openenergymonitor/emontx2/accuracy.md

# emonTx V2 Accuracy Test

### Summary

_The test detailed below performed on one emontx comes to the following conclusion:_

_The error below 40W could not be measured reliably and below 100W it was worse than 10%. Above 100W it was better than 10%, above 150W better than 6%, above 250W better than 4% and above 500W better than 2%._

It may be that your emontx will surpass or fail to achieve these accuracy levels depending on:

1) Calibration - as demonstrated in this test, it may be necessary to apply an additional calibration, the precision of the different components in the circuit means that the voltage calibration can be anywhere between  203.1 – 265.4 while the current sensor calibration can be anywhere between 109.44 – 112.78see [CT and AC power adapter installation and calibration theory](https://learn.openenergymonitor.org/electricity-monitoring/ctac/calibration)

2) Bias position will have a large effect on accuracy at low powers see: [https://learn.openenergymonitor.org/electricity-monitoring/ct-sensors/measurement-implications-of-adc-resolution-at-low-current-values](https://learn.openenergymonitor.org/electricity-monitoring/ct-sensors/measurement-implications-of-adc-resolution-at-low-current-values)

3) Level of electro-magnetic interference in your environment. Some laptops and switch mode power supplies can be a large source ofÂ electro-magnetic interference. Whether your circuit is shielded in any way i.e inside a metal box. A certain level of noise is actually a good thing as it helps overcome the limitations of trying to measure power where the current waveform is close to the ADC level magnitude, by causing the levels to flip higher and lower which after averaging gives a more accurate result.

If you could also repeat this test and post up your results, it would be great to get some comparative data of different emontx's in real world use.

If your also a non-emontx user but have build the emontx circuit on a breadboard, stripboard or arduino shield protoboard it would also be interesting to compare results.

### Test setup

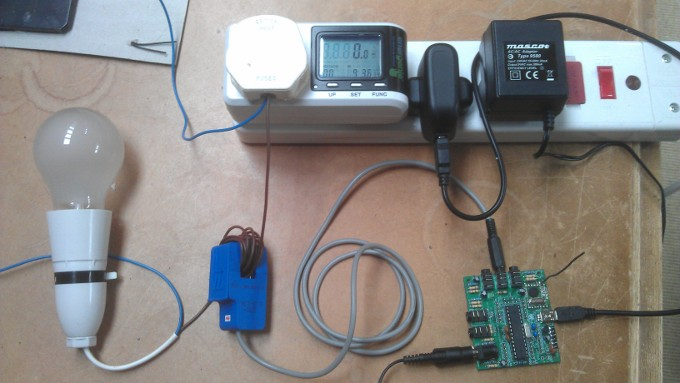
[picture p9: docs/testsetup01.jpg]


The test setup consists of an emontx with the standard Mascot AC-AC voltage adapter for voltage measurement and the standard current sensor, a YHDC sct-013-000 CT. The emonTx is powered via a 5 V USB power supply. The EmonTx sends the realpower values wirelessly to a jeelink that is connected to the computer.

The normal emonTx_CT123_Voltage sketch was used, the measurement rate was increased from once every 5 seconds to twice a second.

The CT is clipped around a modified cable that goes to a fixed load (a 20W and 60W incandescent lightbulb was used in the test). The cable modification was to separate the live and neutral wires and getting enough cable length to wrap around the CT up to 14 times in the case of this test.

A 20W and 60W incandescent lightbulb was used to ensure that the current waveform would be a near-sinusoidal waveform. It is expected that a low energy lightbulb may show higher accuracy at lower powers as its non-linear current draw, a current draw that looks more like a spike at the peak of the mains voltage waveform will utilise more ADC levels, seeÂ [Measurement implications of ADC resolution at low current values](https://learn.openenergymonitor.org/electricity-monitoring/ct-sensors/measurement-implications-of-adc-resolution-at-low-current-values).

### Test procedure

The test was performed in two parts: first 1-14 turns with a 20W lightbulb and second 1-14 turns with a 60W lightbulb. Care was taken each time to make sure that the CT was clipped firmly, that the contact between the split cores where good and that there was no observable effect in trying to push the cores closer together - indicating good contact.

The measurements were logged to a text file and opened and graphed in realtime using KST, an open source data viewing program. KST was set to a data range of 20 datapoints and a label was created to show the Min, Max, Mean and Standard deviation (Sigma) of the power data.

20 datapoints at 2 datapoints a second covers a time window of 10 seconds for eachÂ Min, Max, Mean and Standard deviation measurement. Care was taken to make sure that the mains voltage did not vary significantly during the sample duration.

**Min:** the minimum power value in the sample of 20 datapoints.

**Max:** the maximum power value in the sample of 20 datapoints.

**Mean:** the mean value of the 20 datapoints.

**Standard deviation:** the [standard deviation](https://en.wikipedia.org/wiki/Standard_deviation)Â of the 20 datapoints

These values where logged alongside the actual power as given by the plug meter multiplied by the number of turns in a spreadsheet.

### Uncalibrated ResultsÂ

These are the raw results, its clear that there is a significant calibration error as the error appears to increase in a particular direction linearly:

**The plug in meter column** on the left shows the number of watts as measured on the plug in meter: 21W relates to the actual power consumption of the 20W incandescent lightbulb, 60W relates to the actual power consumption of the 60W lightbulb.

**The number of turn column** is the number of turns of the live or neutral wire in the CT. The number of turns multiplied by the plug in meter power gives the power (or actually current) level as seen by the CT.

<table border="0" cellspacing="0" cols="12" frame="VOID" rules="NONE"><colgroup><col width="103"></colgroup> <colgroup><col width="80"></colgroup> <colgroup><col width="72"></colgroup> <colgroup><col width="77"></colgroup> <colgroup><col width="86"></colgroup> <colgroup><col width="86"></colgroup> <colgroup><col width="86"></colgroup> <colgroup><col width="86"></colgroup> <colgroup><col width="86"></colgroup> <colgroup><col width="86"></colgroup> <colgroup><col width="86"></colgroup> <colgroup><col width="95"></colgroup>

<tbody>

<tr>

<td align="CENTER" height="17" width="103">**plug in meter**</td>

<td align="CENTER" width="80">**no of turns**</td>

<td align="CENTER" width="72">**CT power**</td>

<td align="CENTER" bgcolor="#E6E6FF" width="77">**Max (A)**</td>

<td align="CENTER" bgcolor="#E6E6FF" width="86">**Min (B)**</td>

<td align="CENTER" bgcolor="#E6E6FF" width="86">**Mean**</td>

<td align="CENTER" bgcolor="#E6E6FF" width="86">**Standard Deviation**</td>

<td align="CENTER" width="86">**error (A)**</td>

<td align="CENTER" width="86">**error (B)**</td>

<td align="CENTER" width="86">**% error (A)**</td>

<td align="CENTER" width="86">**% error (B)**</td>

<td align="CENTER" bgcolor="#E6E6FF" width="95">**MAX % error**</td>

</tr>

<tr>

<td align="CENTER" height="17" sdnum="2057;" sdval="21">21</td>

<td align="CENTER" sdnum="2057;" sdval="1">1</td>

<td align="CENTER" sdnum="2057;" sdval="21">21</td>

<td align="CENTER" bgcolor="#E6E6FF" sdnum="2057;" sdval="30">30</td>

<td align="CENTER" bgcolor="#E6E6FF" sdnum="2057;" sdval="10">10</td>

<td align="CENTER" bgcolor="#E6E6FF" sdnum="2057;" sdval="21.8">21.8</td>

<td align="CENTER" bgcolor="#E6E6FF" sdnum="2057;" sdval="5.4">5.4</td>

<td align="CENTER" sdnum="2057;" sdval="9">9</td>

<td align="CENTER" sdnum="2057;" sdval="11">11</td>

<td align="CENTER" sdnum="2057;0;0.00%" sdval="0.428571428571429">42.86%</td>

<td align="CENTER" sdnum="2057;0;0.00%" sdval="0.523809523809524">52.38%</td>

<td align="CENTER" bgcolor="#E6E6FF" sdnum="2057;0;0.00%" sdval="0.523809523809524">52.38%</td>

</tr>

<tr>

<td align="CENTER" height="17" sdnum="2057;" sdval="21">21</td>

<td align="CENTER" sdnum="2057;" sdval="2">2</td>

<td align="CENTER" sdnum="2057;" sdval="42">42</td>

<td align="CENTER" bgcolor="#E6E6FF" sdnum="2057;" sdval="45">45</td>

<td align="CENTER" bgcolor="#E6E6FF" sdnum="2057;" sdval="36">36</td>

<td align="CENTER" bgcolor="#E6E6FF" sdnum="2057;" sdval="39">39</td>

<td align="CENTER" bgcolor="#E6E6FF" sdnum="2057;" sdval="3">3</td>

<td align="CENTER" sdnum="2057;" sdval="3">3</td>

<td align="CENTER" sdnum="2057;" sdval="6">6</td>

<td align="CENTER" sdnum="2057;0;0.00%" sdval="0.0714285714285714">7.14%</td>

<td align="CENTER" sdnum="2057;0;0.00%" sdval="0.142857142857143">14.29%</td>

<td align="CENTER" bgcolor="#E6E6FF" sdnum="2057;0;0.00%" sdval="0.142857142857143">14.29%</td>

</tr>

<tr>

<td align="CENTER" height="17" sdnum="2057;" sdval="21">21</td>

<td align="CENTER" sdnum="2057;" sdval="3">3</td>

<td align="CENTER" sdnum="2057;" sdval="63">63</td>

<td align="CENTER" bgcolor="#E6E6FF" sdnum="2057;" sdval="63">63</td>

<td align="CENTER" bgcolor="#E6E6FF" sdnum="2057;" sdval="52">52</td>

<td align="CENTER" bgcolor="#E6E6FF" sdnum="2057;" sdval="60">60</td>

<td align="CENTER" bgcolor="#E6E6FF" sdnum="2057;" sdval="3.3">3.3</td>

<td align="CENTER" sdnum="2057;" sdval="0">0</td>

<td align="CENTER" sdnum="2057;" sdval="11">11</td>

<td align="CENTER" sdnum="2057;0;0.00%" sdval="0">0.00%</td>

<td align="CENTER" sdnum="2057;0;0.00%" sdval="0.174603174603175">17.46%</td>

<td align="CENTER" bgcolor="#E6E6FF" sdnum="2057;0;0.00%" sdval="0.174603174603175">17.46%</td>

</tr>

<tr>

<td align="CENTER" height="17" sdnum="2057;" sdval="21">21</td>

<td align="CENTER" sdnum="2057;" sdval="4">4</td>

<td align="CENTER" sdnum="2057;" sdval="84">84</td>

<td align="CENTER" bgcolor="#E6E6FF" sdnum="2057;" sdval="83">83</td>

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

</tr>

<tr>

<td align="CENTER" height="17" sdnum="2057;" sdval="61">61</td>

<td align="CENTER" sdnum="2057;" sdval="13">13</td>

<td align="CENTER" sdnum="2057;" sdval="793">793</td>

<td align="CENTER" bgcolor="#E6E6FF" sdnum="2057;" sdval="752">752</td>

<td align="CENTER" bgcolor="#E6E6FF" sdnum="2057;" sdval="743">743</td>

<td align="CENTER" bgcolor="#E6E6FF" sdnum="2057;" sdval="746">746</td>

<td align="CENTER" bgcolor="#E6E6FF" sdnum="2057;" sdval="2.2">2.2</td>

<td align="CENTER" sdnum="2057;" sdval="-41">-41</td>

<td align="CENTER" sdnum="2057;" sdval="50">50</td>

<td align="CENTER" sdnum="2057;0;0.00%" sdval="-0.0517023959646911">-5.17%</td>

<td align="CENTER" sdnum="2057;0;0.00%" sdval="0.0630517023959647">6.31%</td>

<td align="CENTER" bgcolor="#E6E6FF" sdnum="2057;0;0.00%" sdval="0.0630517023959647">6.31%</td>

</tr>

<tr>

<td align="CENTER" height="17" sdnum="2057;" sdval="61">61</td>

<td align="CENTER" sdnum="2057;" sdval="14">14</td>

<td align="CENTER" sdnum="2057;" sdval="854">854</td>

<td align="CENTER" bgcolor="#E6E6FF" sdnum="2057;" sdval="805">805</td>

<td align="CENTER" bgcolor="#E6E6FF" sdnum="2057;" sdval="798">798</td>

<td align="CENTER" bgcolor="#E6E6FF" sdnum="2057;" sdval="801">801</td>

<td align="CENTER" bgcolor="#E6E6FF" sdnum="2057;" sdval="2.2">2.2</td>

<td align="CENTER" sdnum="2057;" sdval="-49">-49</td>

<td align="CENTER" sdnum="2057;" sdval="56">56</td>

<td align="CENTER" sdnum="2057;0;0.00%" sdval="-0.0573770491803279">-5.74%</td>

<td align="CENTER" sdnum="2057;0;0.00%" sdval="0.0655737704918033">6.56%</td>

<td align="CENTER" bgcolor="#E6E6FF" sdnum="2057;0;0.00%" sdval="0.0655737704918033">6.56%</td>

</tr>

</tbody>

</table>

### Applying a calibration

The calibration factor was calculated by dividing the plug in power 854W by the mean emontx power of 801W.

**Calibration factor: 1.066**

The next question is whether this error is down to voltage measurement only or is also down to current measurement or some other source. Comparing the voltage measured on the plug meter: 251.2V and the emontx 242.5 it looks like the difference here accounts for just over half the error.Â

Applying the calibration:

<table border="0" cellspacing="0" cols="14" frame="VOID" rules="NONE"><colgroup><col width="86"></colgroup> <colgroup><col width="86"></colgroup> <colgroup><col width="86"></colgroup> <colgroup><col width="86"></colgroup> <colgroup><col width="86"></colgroup> <colgroup><col width="86"></colgroup> <colgroup><col width="86"></colgroup> <colgroup><col width="86"></colgroup> <colgroup><col width="86"></colgroup> <colgroup><col width="86"></colgroup> <colgroup><col width="86"></colgroup> <colgroup><col width="86"></colgroup> <colgroup><col width="86"></colgroup> <colgroup><col width="121"></colgroup>

<tbody>

<tr>

<td align="CENTER" height="17" width="86">**plug in meter**</td>

<td align="CENTER" width="86">**no of turns**</td>

<td align="CENTER" width="86">**CT power**</td>

<td align="CENTER" width="86">**Max**</td>

<td align="CENTER" width="86">**Min**</td>

<td align="CENTER" bgcolor="#E6E6FF" width="86">**Max CAL (A)**</td>

<td align="CENTER" bgcolor="#E6E6FF" width="86">**Min CAL (B)**</td>

<td align="CENTER" width="86">**Mean**</td>

<td align="CENTER" width="86">

**Standard Deviation**

</td>

<td align="CENTER" sdnum="2057;0;0.0" width="86">**error (A)**</td>

<td align="CENTER" sdnum="2057;0;0.0" width="86">

**error (B)**

</td>

<td align="CENTER" sdnum="2057;0;0.0" width="86">**% error (A)**</td>

<td align="CENTER" sdnum="2057;0;0.0" width="86">**% error (B)**</td>

<td align="CENTER" bgcolor="#E6E6FF" width="121">**MAX % error**</td>

</tr>

<tr>

<td align="CENTER" height="17" sdnum="2057;" sdval="21">21</td>

<td align="CENTER" sdnum="2057;" sdval="1">1</td>

<td align="CENTER" sdnum="2057;" sdval="21">21</td>

<td align="CENTER" sdnum="2057;" sdval="30">30</td>

<td align="CENTER" sdnum="2057;" sdval="10">10</td>

<td align="CENTER" bgcolor="#E6E6FF" sdnum="2057;0;0" sdval="31.9850187265918">32</td>

<td align="CENTER" bgcolor="#E6E6FF" sdnum="2057;0;0" sdval="10.6616729088639">11</td>

<td align="CENTER" sdnum="2057;" sdval="21.8">21.8</td>

<td align="CENTER" sdnum="2057;" sdval="5.4">5.4</td>

<td align="CENTER" sdnum="2057;0;0.0" sdval="10.9850187265918">11.0</td>

<td align="CENTER" sdnum="2057;0;0.0" sdval="10.3383270911361">10.3</td>

<td align="CENTER" sdnum="2057;0;0.00%" sdval="0.523096129837703">52.31%</td>

<td align="CENTER" sdnum="2057;0;0.00%" sdval="0.492301290054099">49.23%</td>

<td align="CENTER" bgcolor="#E6E6FF" sdnum="2057;0;0.00%" sdval="0.523096129837703">52.31%</td>

</tr>

<tr>

<td align="CENTER" height="17" sdnum="2057;" sdval="21">21</td>

<td align="CENTER" sdnum="2057;" sdval="2">2</td>

<td align="CENTER" sdnum="2057;" sdval="42">42</td>

<td align="CENTER" sdnum="2057;" sdval="45">45</td>

<td align="CENTER" sdnum="2057;" sdval="36">36</td>

<td align="CENTER" bgcolor="#E6E6FF" sdnum="2057;0;0" sdval="47.9775280898876">48</td>

<td align="CENTER" bgcolor="#E6E6FF" sdnum="2057;0;0" sdval="38.3820224719101">38</td>

<td align="CENTER" sdnum="2057;" sdval="39">39</td>

<td align="CENTER" sdnum="2057;" sdval="3">3</td>

<td align="CENTER" sdnum="2057;0;0.0" sdval="5.97752808988763">6.0</td>

<td align="CENTER" sdnum="2057;0;0.0" sdval="3.61797752808989">3.6</td>

<td align="CENTER" sdnum="2057;0;0.00%" sdval="0.142322097378277">14.23%</td>

<td align="CENTER" sdnum="2057;0;0.00%" sdval="0.0861423220973783">8.61%</td>

<td align="CENTER" bgcolor="#E6E6FF" sdnum="2057;0;0.00%" sdval="0.142322097378277">14.23%</td>

</tr>

<tr>

<td align="CENTER" height="17" sdnum="2057;" sdval="61">61</td>

<td align="CENTER" sdnum="2057;" sdval="1">1</td>

<td align="CENTER" sdnum="2057;" sdval="61">61</td>

<td align="CENTER" sdnum="2057;" sdval="64">64</td>

<td align="CENTER" sdnum="2057;" sdval="57">57</td>

<td align="CENTER" bgcolor="#E6E6FF" sdnum="2057;0;0" sdval="68.2347066167291">68</td>

<td align="CENTER" bgcolor="#E6E6FF" sdnum="2057;0;0" sdval="60.7715355805243">61</td>

<td align="CENTER" sdnum="2057;" sdval="62.2">62.2</td>

<td align="CENTER" sdnum="2057;" sdval="2">2</td>

<td align="CENTER" sdnum="2057;0;0.0" sdval="7.23470661672909">7.2</td>

<td align="CENTER" sdnum="2057;0;0.0" sdval="0.228464419475657">0.2</td>

<td align="CENTER" sdnum="2057;0;0.00%" sdval="0.118601747815231">11.86%</td>

<td align="CENTER" sdnum="2057;0;0.00%" sdval="0.00374531835205994">0.37%</td>

<td align="CENTER" bgcolor="#E6E6FF" sdnum="2057;0;0.00%" sdval="0.118601747815231">11.86%</td>

</tr>

<tr>

<td align="CENTER" height="17" sdnum="2057;" sdval="21">21</td>

<td align="CENTER" sdnum="2057;" sdval="3">3</td>

<td align="CENTER" sdnum="2057;" sdval="63">63</td>

<td align="CENTER" sdnum="2057;" sdval="63">63</td>

<td align="CENTER" sdnum="2057;" sdval="52">52</td>

<td align="CENTER" bgcolor="#E6E6FF" sdnum="2057;0;0" sdval="67.1685393258427">67</td>

<td align="CENTER" bgcolor="#E6E6FF" sdnum="2057;0;0" sdval="55.4406991260924">55</td>

<td align="CENTER" sdnum="2057;" sdval="60">60</td>

<td align="CENTER" sdnum="2057;" sdval="3.3">3.3</td>

<td align="CENTER" sdnum="2057;0;0.0" sdval="4.16853932584269">4.2</td>

<td align="CENTER" sdnum="2057;0;0.0" sdval="7.55930087390762">7.6</td>

<td align="CENTER" sdnum="2057;0;0.00%" sdval="0.0661672908863919">6.62%</td>

<td align="CENTER" sdnum="2057;0;0.00%" sdval="0.119988902760438">12.00%</td>

<td align="CENTER" bgcolor="#E6E6FF" sdnum="2057;0;0.00%" sdval="0.119988902760438">12.00%</td>

</tr>

<tr>

<td align="CENTER" height="17" sdnum="2057;" sdval="21">21</td>

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

<td align="CENTER" bgcolor="#E6E6FF" sdnum="2057;0;0" sdval="792.162297128589">792</td>

<td align="CENTER" sdnum="2057;" sdval="746">746</td>

<td align="CENTER" sdnum="2057;" sdval="2.2">2.2</td>

<td align="CENTER" sdnum="2057;0;0.0" sdval="8.75780274656677">8.8</td>

<td align="CENTER" sdnum="2057;0;0.0" sdval="0.837702871410784">0.8</td>

<td align="CENTER" sdnum="2057;0;0.00%" sdval="0.0110438874483818">1.10%</td>

<td align="CENTER" sdnum="2057;0;0.00%" sdval="0.00105637184288876">0.11%</td>

<td align="CENTER" bgcolor="#E6E6FF" sdnum="2057;0;0.00%" sdval="0.0110438874483818">1.10%</td>

</tr>

<tr>

<td align="CENTER" height="17" sdnum="2057;" sdval="61">61</td>

<td align="CENTER" sdnum="2057;" sdval="14">14</td>

<td align="CENTER" sdnum="2057;" sdval="854">854</td>

<td align="CENTER" sdnum="2057;" sdval="805">805</td>

<td align="CENTER" sdnum="2057;" sdval="798">798</td>

<td align="CENTER" bgcolor="#E6E6FF" sdnum="2057;0;0" sdval="858.264669163546">858</td>

<td align="CENTER" bgcolor="#E6E6FF" sdnum="2057;0;0" sdval="850.801498127341">851</td>

<td align="CENTER" sdnum="2057;" sdval="801">801</td>

<td align="CENTER" sdnum="2057;" sdval="2.2">2.2</td>

<td align="CENTER" sdnum="2057;0;0.0" sdval="4.26466916354548">4.3</td>

<td align="CENTER" sdnum="2057;0;0.0" sdval="3.19850187265922">3.2</td>

<td align="CENTER" sdnum="2057;0;0.00%" sdval="0.00499375780274646">0.50%</td>

<td align="CENTER" sdnum="2057;0;0.00%" sdval="0.00374531835205998">0.37%</td>

<td align="CENTER" bgcolor="#E6E6FF" sdnum="2057;0;0.00%" sdval="0.00499375780274646">0.50%</td>

</tr>

</tbody>

</table>

### Plot of Maximum error at power

[](docs/emontxerrorplots01.png)

### Removing the first and largest error value so that we can better see the other datapoints:

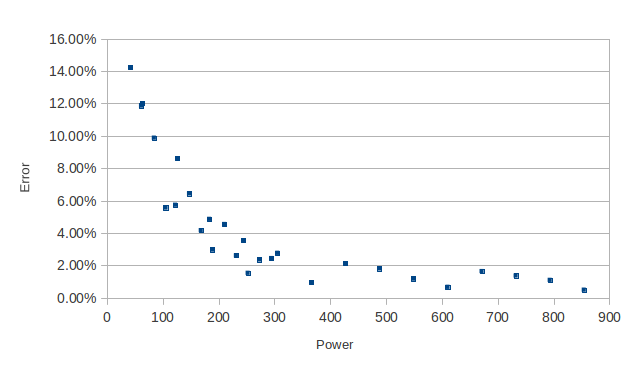
[picture p10: docs/emontxerrorplots02.png]


## Update

<span class="submitted">[cagabi](https://openenergymonitor.org/emon/user/11 "View user profile.")</span> has repeated the tests and his results after calibration:

*   For measurements below 50W: error >34%
*   For measurements 50W - 100W: error >5%
*   For measurementsÂ 100W - 240 W: 2% < error < 5%
*   For measurements above the 300W: error < 1% (more less)

The results in a graph:

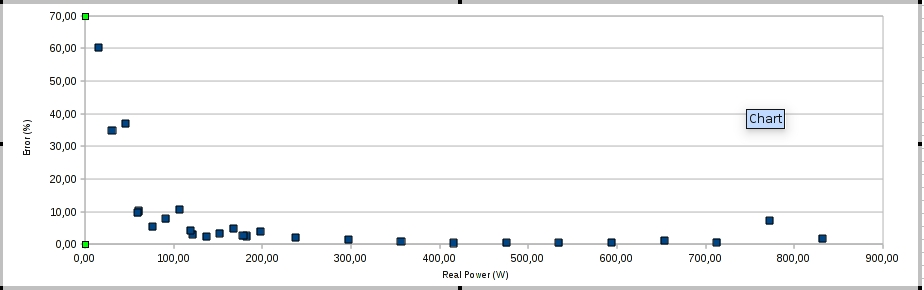
[picture p11: docs/cagabi-Accuracy-test-emonTX.jpg]


</div>
