openenergymonitor/emontx2/docs/emontxerrorplots01.png

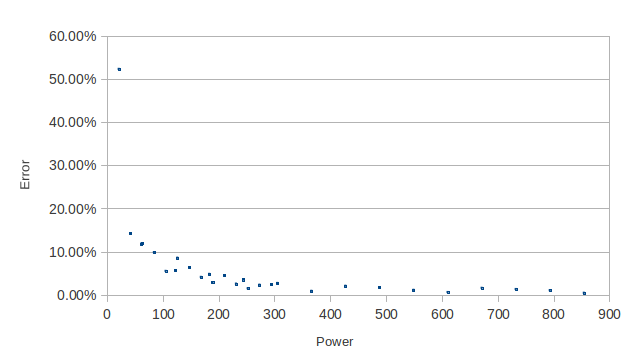
docs/emontxerrorplots01.png
